rk2224/fpga-sdr/images/fm_bpf_lpf_hardware.jpeg

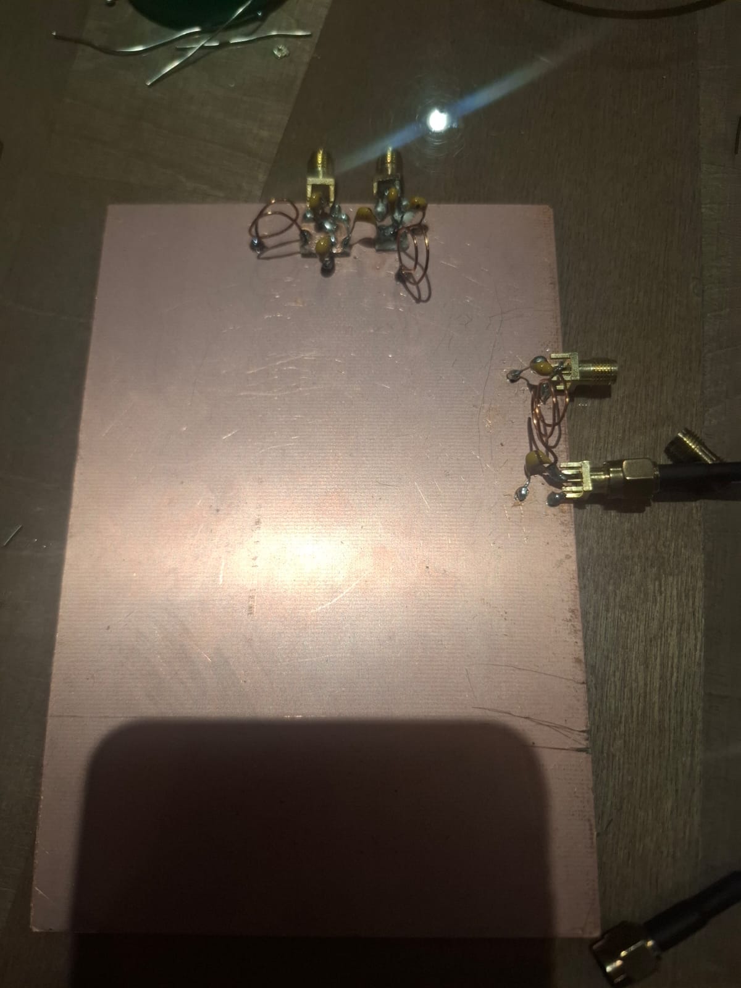
images/fm_bpf_lpf_hardware.jpeg
