rk2224/fpga-sdr/measurements/adcantenna.csv

Groups:
ADC_IN[11..0] = | ADC_IN[11] | ADC_IN[10] | ADC_IN[9] | ADC_IN[8] | ADC_IN[7] | ADC_IN[6] | ADC_IN[5] | ADC_IN[4] | ADC_IN[3] | ADC_IN[2] | ADC_IN[1] | ADC_IN[0] | hex
SW[9..0] = | SW[9] | SW[8] | SW[7] | SW[6] | SW[5] | SW[4] | SW[3] | SW[2] | SW[1] | SW[0] | hex
Data:
time unit: s | ADC_IN[11..0] | ADC_IN[11] | ADC_IN[10] | ADC_IN[9] | ADC_IN[8] | ADC_IN[7] | ADC_IN[6] | ADC_IN[5] | ADC_IN[4] | ADC_IN[3] | ADC_IN[2] | ADC_IN[1] | ADC_IN[0] | SW[9..0] | SW[9] | SW[8] | SW[7] | SW[6] | SW[5] | SW[4] | SW[3] | SW[2] | SW[1] | SW[0]
0 | XXX | X | X | X | X | X | X | X | X | X | X | X | X | XXX | X | X | X | X | X | X | X | X | X | X
1 | 7E5 | 0 | 1 | 1 | 1 | 1 | 1 | 1 | 0 | 0 | 1 | 0 | 1 | 000 | 0 | 0 | 0 | 0 | 0 | 0 | 0 | 0 | 0 | 0
2 | 7E5 | 0 | 1 | 1 | 1 | 1 | 1 | 1 | 0 | 0 | 1 | 0 | 1 | 000 | 0 | 0 | 0 | 0 | 0 | 0 | 0 | 0 | 0 | 0
3 | 7E5 | 0 | 1 | 1 | 1 | 1 | 1 | 1 | 0 | 0 | 1 | 0 | 1 | 000 | 0 | 0 | 0 | 0 | 0 | 0 | 0 | 0 | 0 | 0
4 | 7E5 | 0 | 1 | 1 | 1 | 1 | 1 | 1 | 0 | 0 | 1 | 0 | 1 | 000 | 0 | 0 | 0 | 0 | 0 | 0 | 0 | 0 | 0 | 0
5 | 7E4 | 0 | 1 | 1 | 1 | 1 | 1 | 1 | 0 | 0 | 1 | 0 | 0 | 000 | 0 | 0 | 0 | 0 | 0 | 0 | 0 | 0 | 0 | 0
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
